Ron-Z/PCB_SD04-PCM-DW01/705_PCB_SD04-PCM-DW01/191212_shark04_dw01/readme.md

### Change log

v0.1 Draft release

v0.2 - 20200316

- 根据需求增加了 均衡指示灯
- 修改了部分不合理的布线。
