Ron-Z/PCB_SD04-PCM-DW01/705_PCB_SD04-PCM-DW01/191212_shark04_dw01/00_documentation/6A637312932F483C8EEC1C25A4D09317_419.jpg

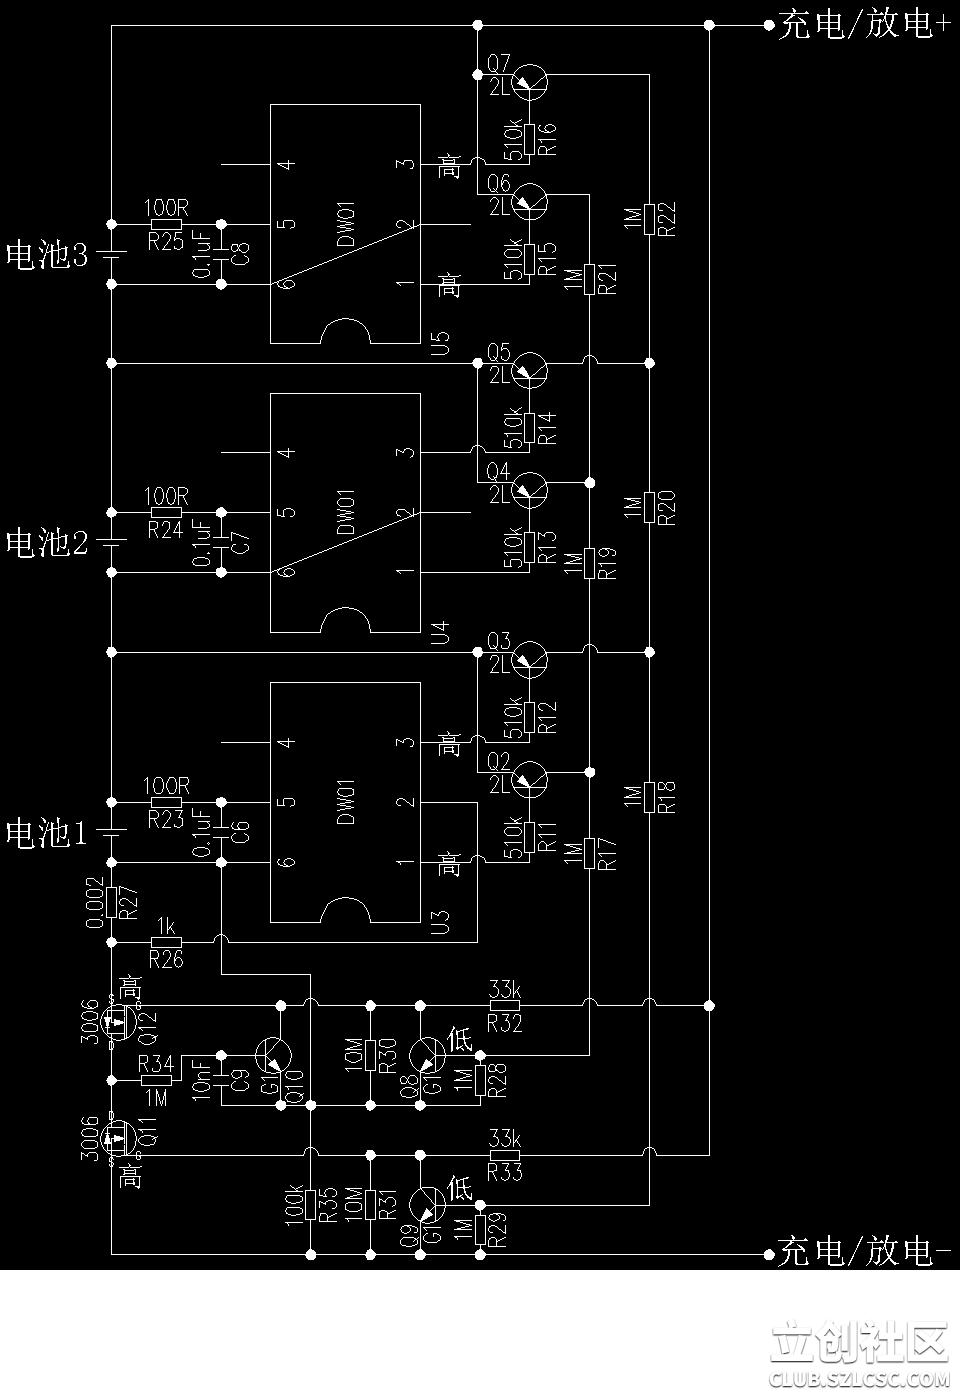
705_PCB_SD04-PCM-DW01/191212_shark04_dw01/00_documentation/6A637312932F483C8EEC1C25A4D09317_419.jpg
