Ron-Z/PCB_SD04-PCM-DW01/705_PCB_SD04-PCM-DW01/191212_shark04_dw01/00_documentation/20190611191539315.png

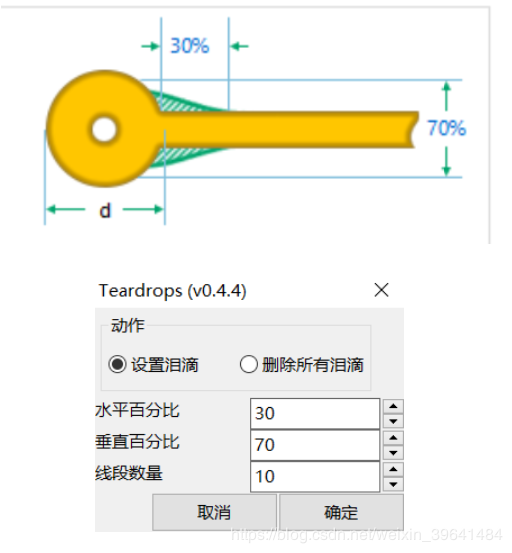
705_PCB_SD04-PCM-DW01/191212_shark04_dw01/00_documentation/20190611191539315.png
