Ron-Z/PCB_SD04-PCM-DW01/705_PCB_SD04-PCM-DW01/191212_shark04_dw01/00_documentation/DW01_ORG.png

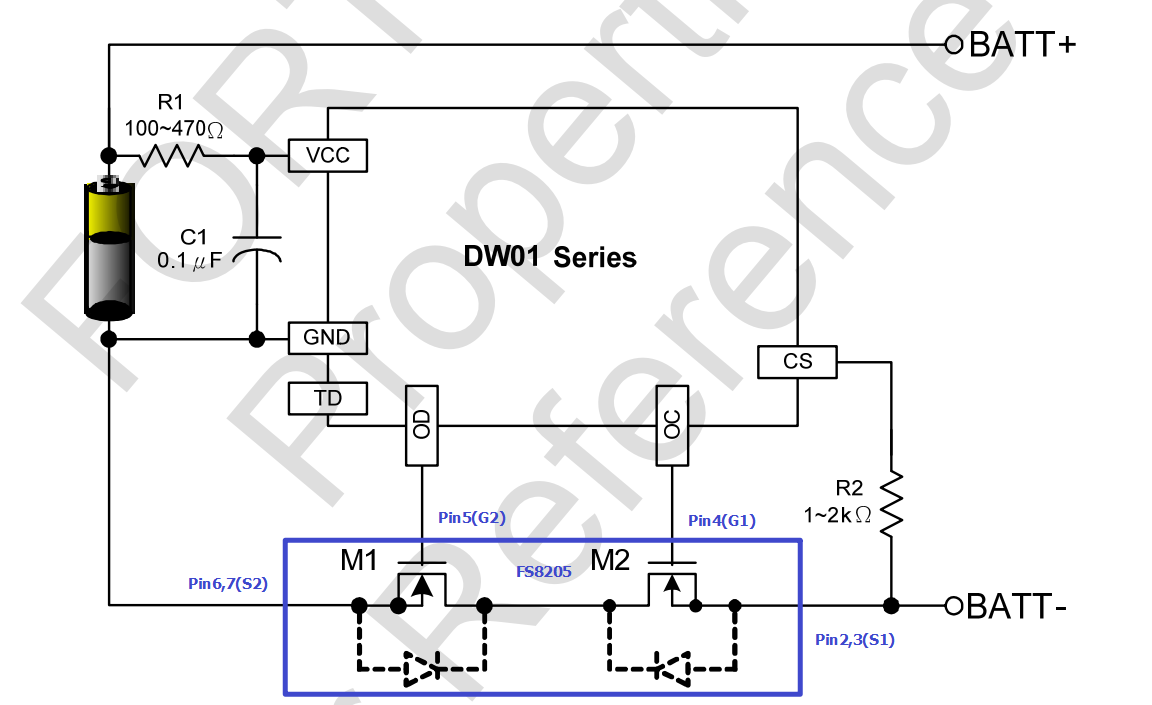
705_PCB_SD04-PCM-DW01/191212_shark04_dw01/00_documentation/DW01_ORG.png
