Ron-Z/PCB_SD04-PCM-DW01/705_PCB_SD04-PCM-DW01/191212_shark04_dw01/40_photos/SideView_SD04_v0.2.png

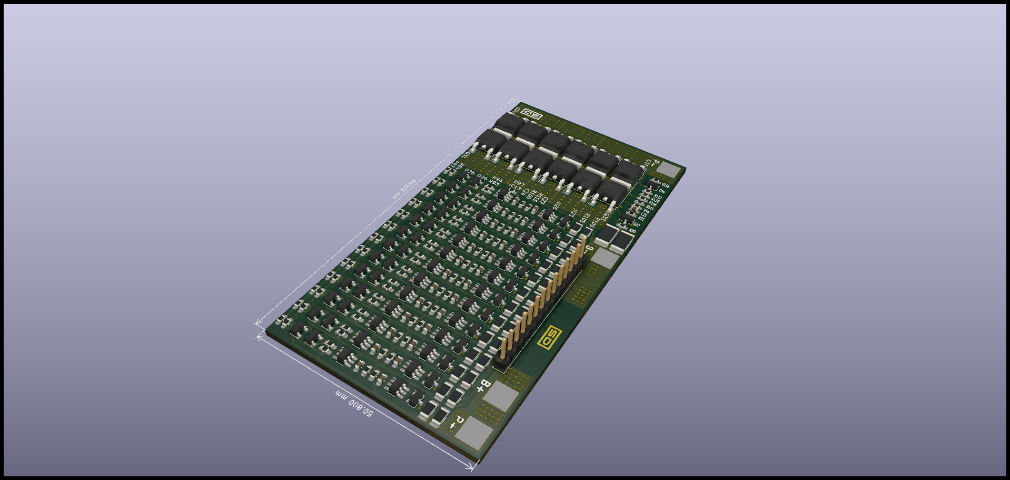
705_PCB_SD04-PCM-DW01/191212_shark04_dw01/40_photos/SideView_SD04_v0.2.png
