Ron-Z/PCB_SD04-PCM-DW01/705_PCB_SD04-PCM-DW01/191212_shark04_dw01/sd04.csv

Reference | Value | Footprint | Datasheet | Field4 | P | detail | 字段5 | 字段4
U11 | HY2213-BB3A | Package_TO_SOT_SMD:SOT-23-6_Handsoldering | https://datasheet.lcsc.com/szlcsc/HYCON-Tech-HY2213-BB3A_C113632.pdf
U1 | SLS2302 | Package_TO_SOT_SMD:SOT-23 | ~
R52 | 150R | Resistor_SMD:R_1206_3216Metric_Pad1.42x1.75mm_HandSolder
C11 | 0.1uF | Capacitor_SMD:C_0603_1608Metric_Pad1.05x0.95mm_HandSolder | ~
R72 | 100R | Resistor_SMD:R_0603_1608Metric_Pad1.05x0.95mm_HandSolder
R42 | 100R | Resistor_SMD:R_0603_1608Metric_Pad1.05x0.95mm_HandSolder
C1 | 0.1uF | Capacitor_SMD:C_0603_1608Metric_Pad1.05x0.95mm_HandSolder | ~
IC1 | DW01A-G | Package_TO_SOT_SMD:SOT-23-6_Handsoldering
Q2 | MMBT3906 | Package_TO_SOT_SMD:SOT-23 | https://www.fairchildsemi.com/datasheets/2N/2N3906.pdf
Q1 | MMBT3906 | Package_TO_SOT_SMD:SOT-23 | https://www.fairchildsemi.com/datasheets/2N/2N3906.pdf
R22 | 510K | Resistor_SMD:R_0603_1608Metric_Pad1.05x0.95mm_HandSolder
R23 | 510K | Resistor_SMD:R_0603_1608Metric_Pad1.05x0.95mm_HandSolder
R1 | 1M | Resistor_SMD:R_0603_1608Metric_Pad1.05x0.95mm_HandSolder
R12 | 1M | Resistor_SMD:R_0603_1608Metric_Pad1.05x0.95mm_HandSolder
U12 | HY2213-BB3A | Package_TO_SOT_SMD:SOT-23-6_Handsoldering | https://datasheet.lcsc.com/szlcsc/HYCON-Tech-HY2213-BB3A_C113632.pdf
U2 | SLS2302 | Package_TO_SOT_SMD:SOT-23 | ~
C12 | 0.1uF | Capacitor_SMD:C_0603_1608Metric_Pad1.05x0.95mm_HandSolder | ~
R73 | 100R | Resistor_SMD:R_0603_1608Metric_Pad1.05x0.95mm_HandSolder
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
H3 | P- | SolderWirePad_1x01_SMD_5x5mm:SolderWirePad_1x01_SMD_5x5mm | ~
J1 | CONN_14 | Connector_PinHeader_2.54mm:PinHeader_1x14_P2.54mm_Vertical |  |  |  |  |  | XXX-00000
H4 | P+ | SolderWirePad_1x01_SMD_5x5mm:SolderWirePad_1x01_SMD_5x5mm | ~
