Ron-Z/PCB_SD04-PCM-DW01/705_PCB_SD04-PCM-DW01/191212_shark04_dw01/99_others/FS8205A/FS8205A--3DModel-STEP-56544.STEP

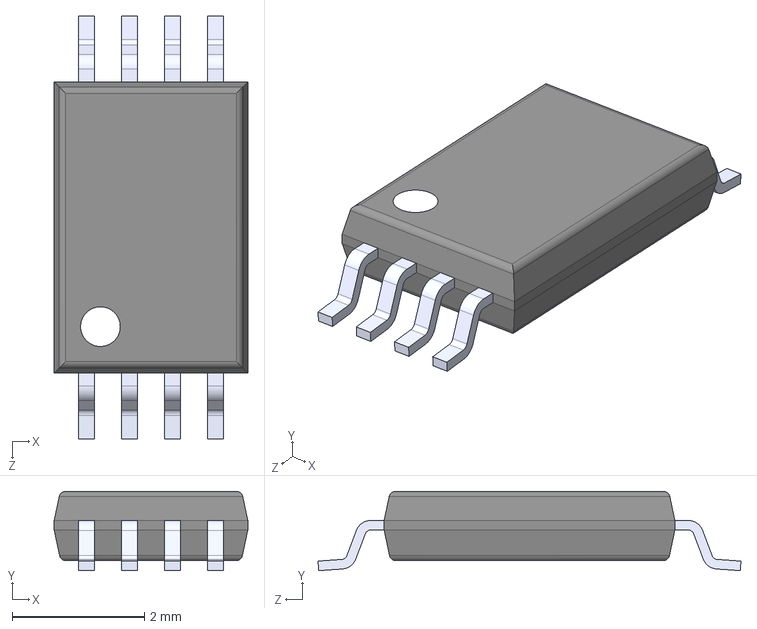
[picture p17: CAD file, 2020-03-17]
705_PCB_SD04-PCM-DW01/191212_shark04_dw01/99_others/FS8205A/FS8205A--3DModel-STEP-56544.STEP
2.93 x 1.20 x 6.40 mm
