Ron-Z/PCB_SD04-PCM-DW01/705_PCB_SD04-PCM-DW01/191212_shark04_dw01/preview_pcb.pdf

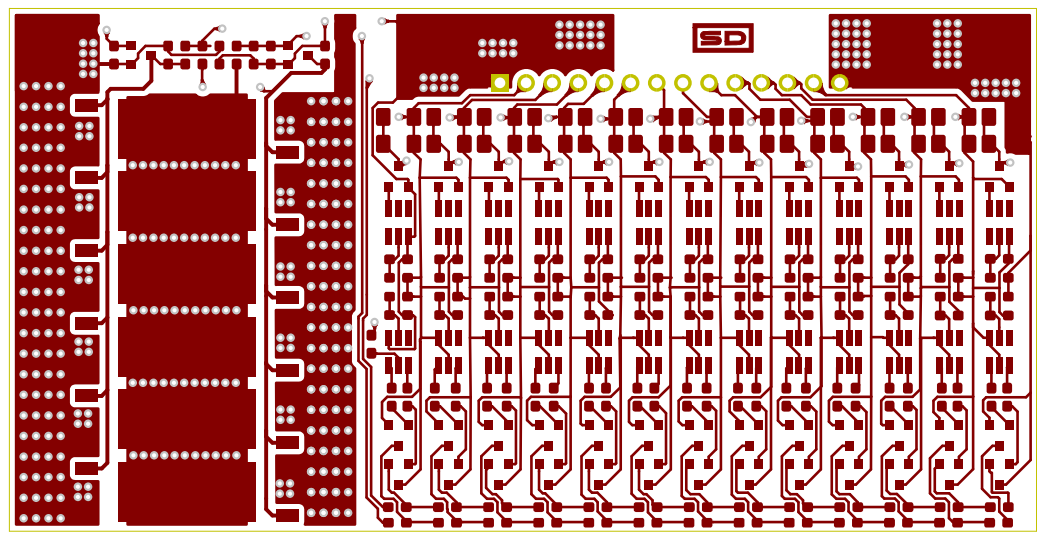
[picture p18: page 1]

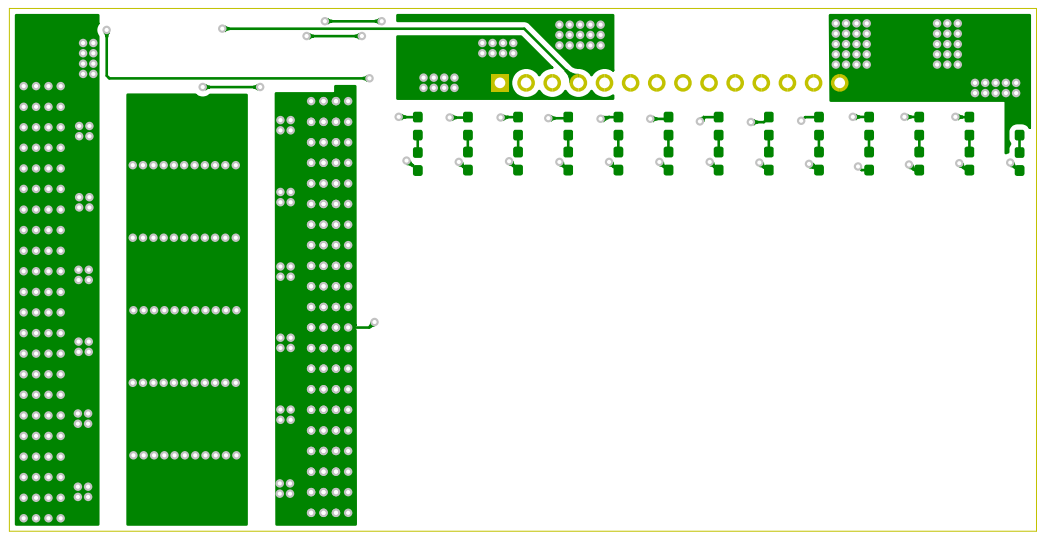
[picture p19: page 2]

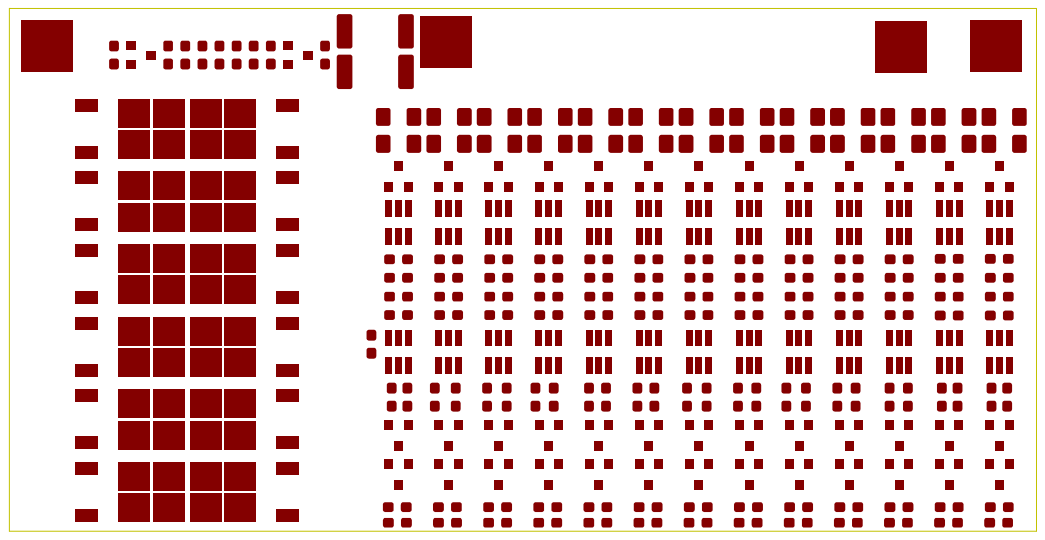
[picture p20: page 5]

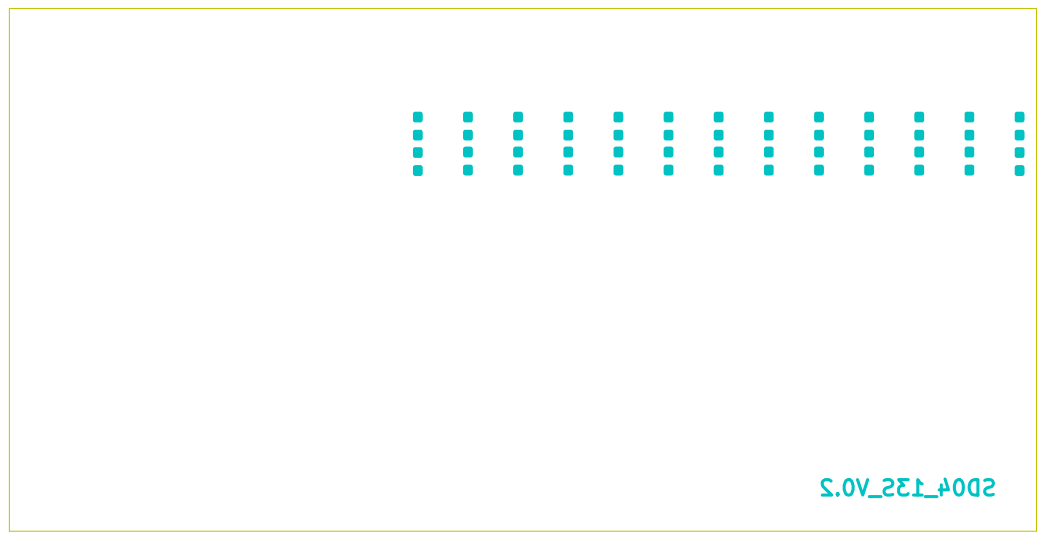
[picture p21: page 6]

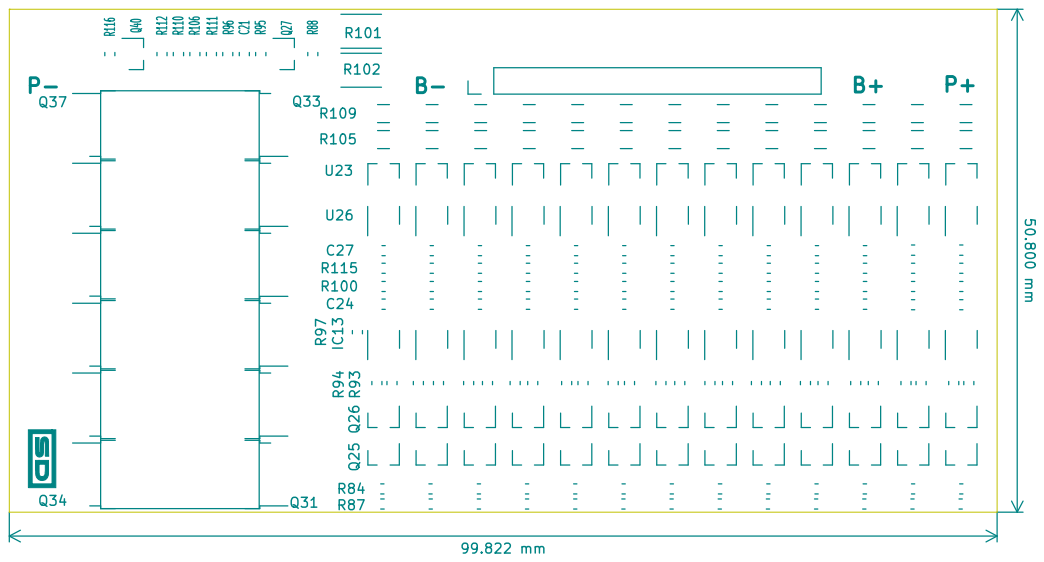
[picture p22: page 7]

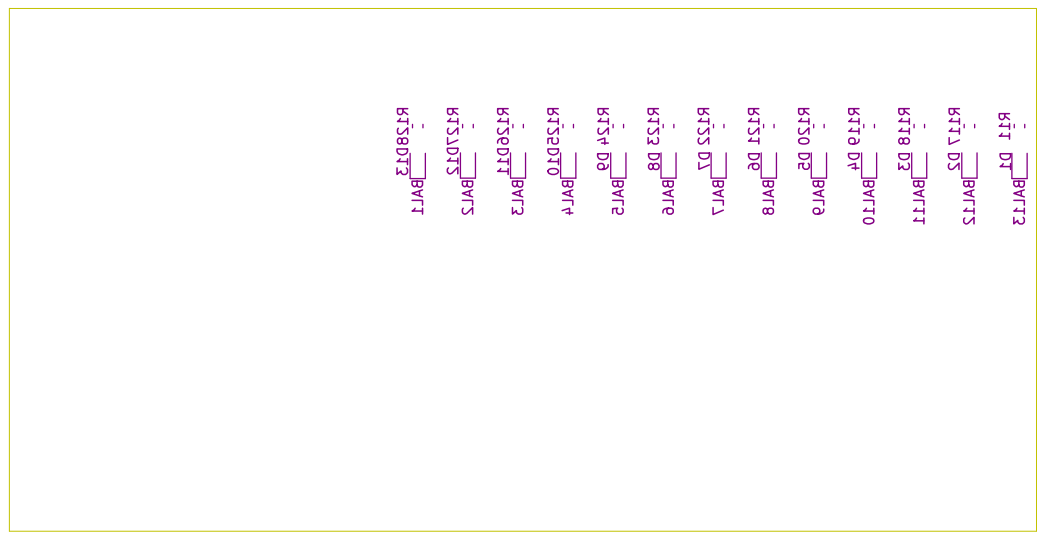
[picture p23: page 8]

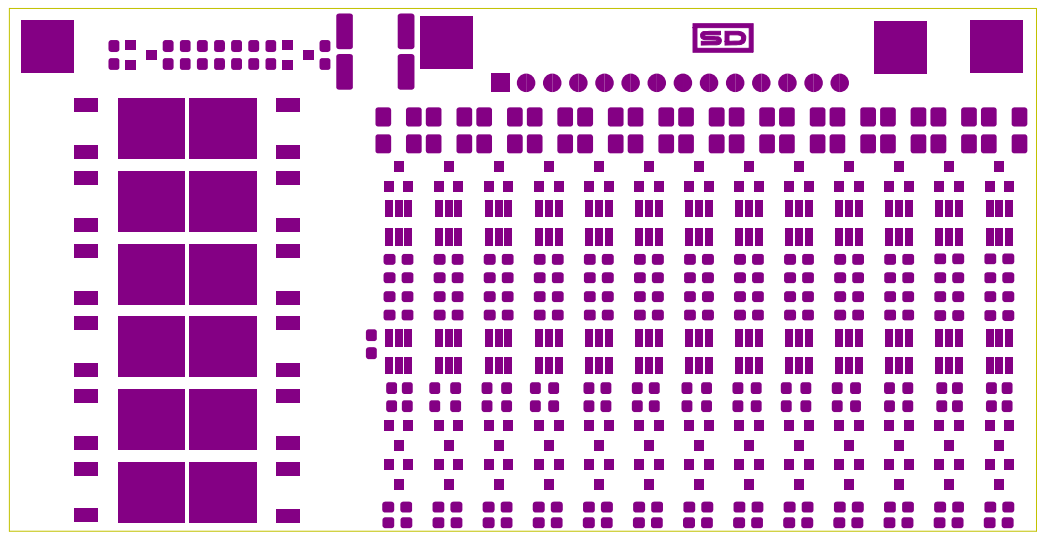
[picture p24: page 9]

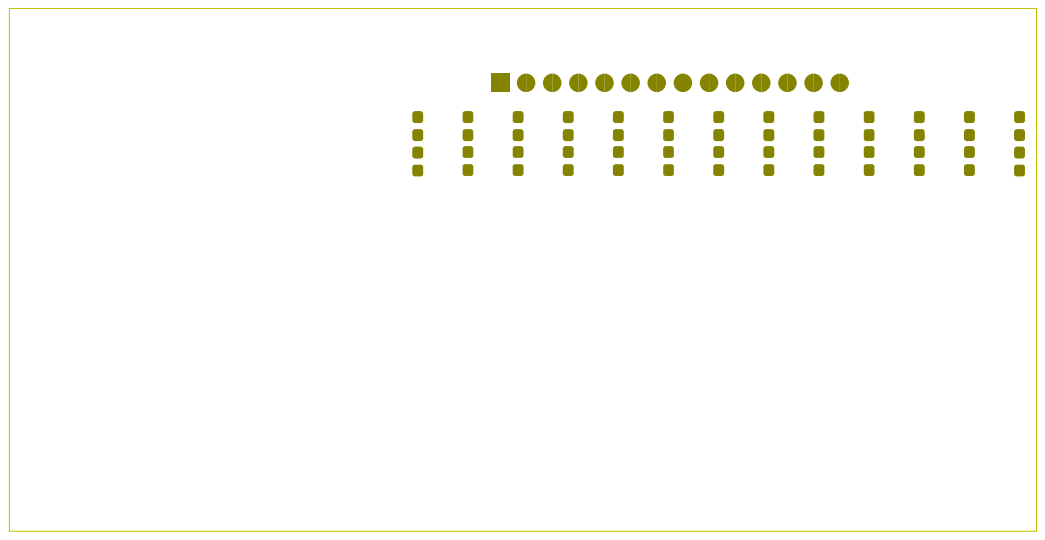
[picture p25: page 10]

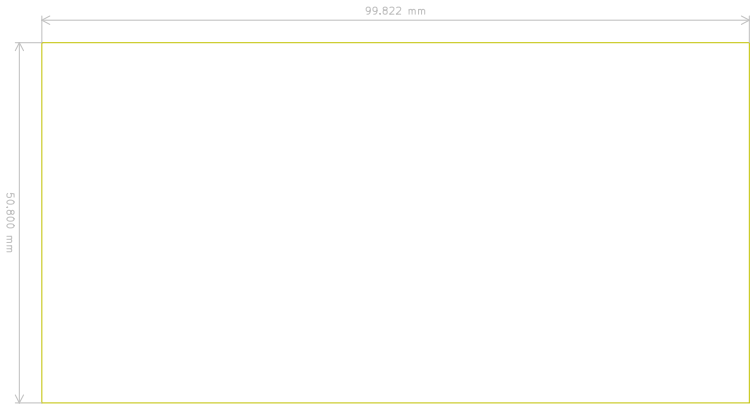
[picture p26: figure]

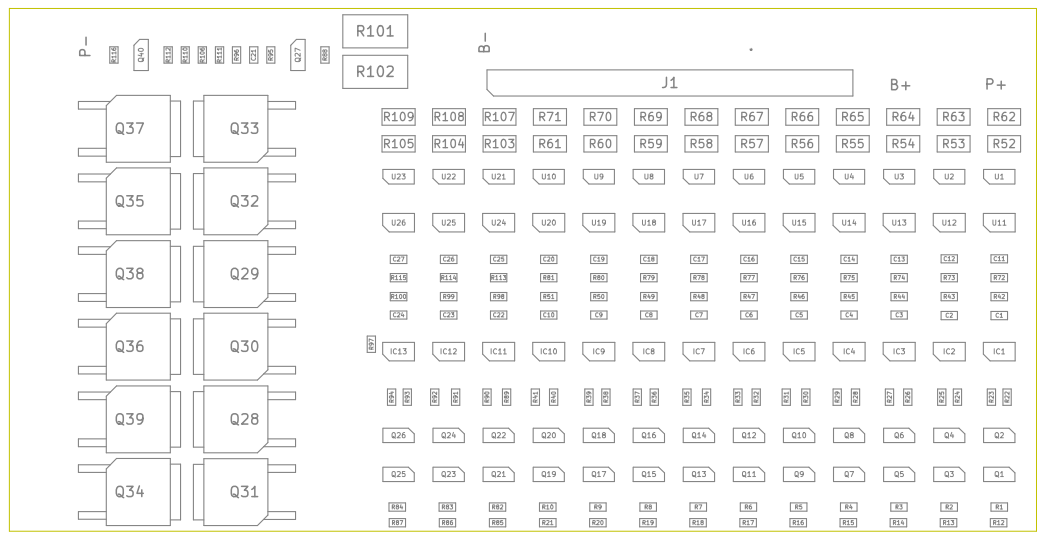
[picture p27: page 19]

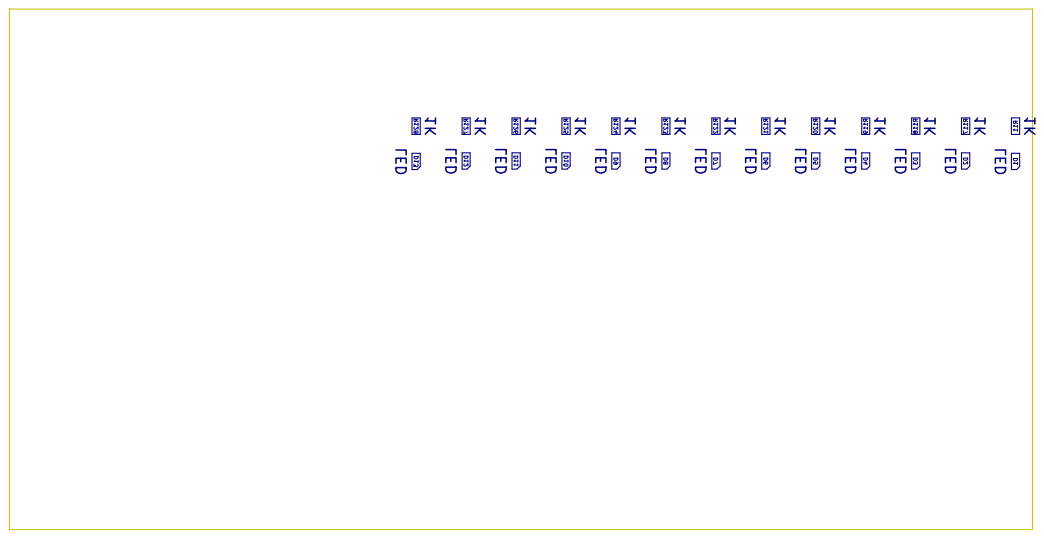
[picture p28: page 20]
