Ron-Z/PCB_SD04-PCM-DW01/705_PCB_SD04-PCM-DW01/191212_shark04_dw01/50_simulation/Gate.asc

M1: nmos
M2: nmos
M3: pmos
Q1: npn
Q2: npn
R1: res; 1Meg
R2: res; 1Meg
R3: res; 10Meg
R4: res; 1Meg
R5: res; 1
R6: res; 1Meg
R7: res; 10Meg
R8: res; 1Meg
V1: cell
V2: cell
V3: cell
V4: cell
V5: cell
V6: cell
V7: cell
V8: cell
V9: cell
V10: voltage
Named nets: 0, VCC
.tran 1
