Ron-Z/PCB_SD04-PCM-DW01/705_PCB_SD04-PCM-DW01/191212_shark04_dw01/sd04.kicad_pcb

## KiCad design 705_PCB_SD04-PCM-DW01/191212_shark04_dw01/sd04.kicad_pcb (2020-03-17)

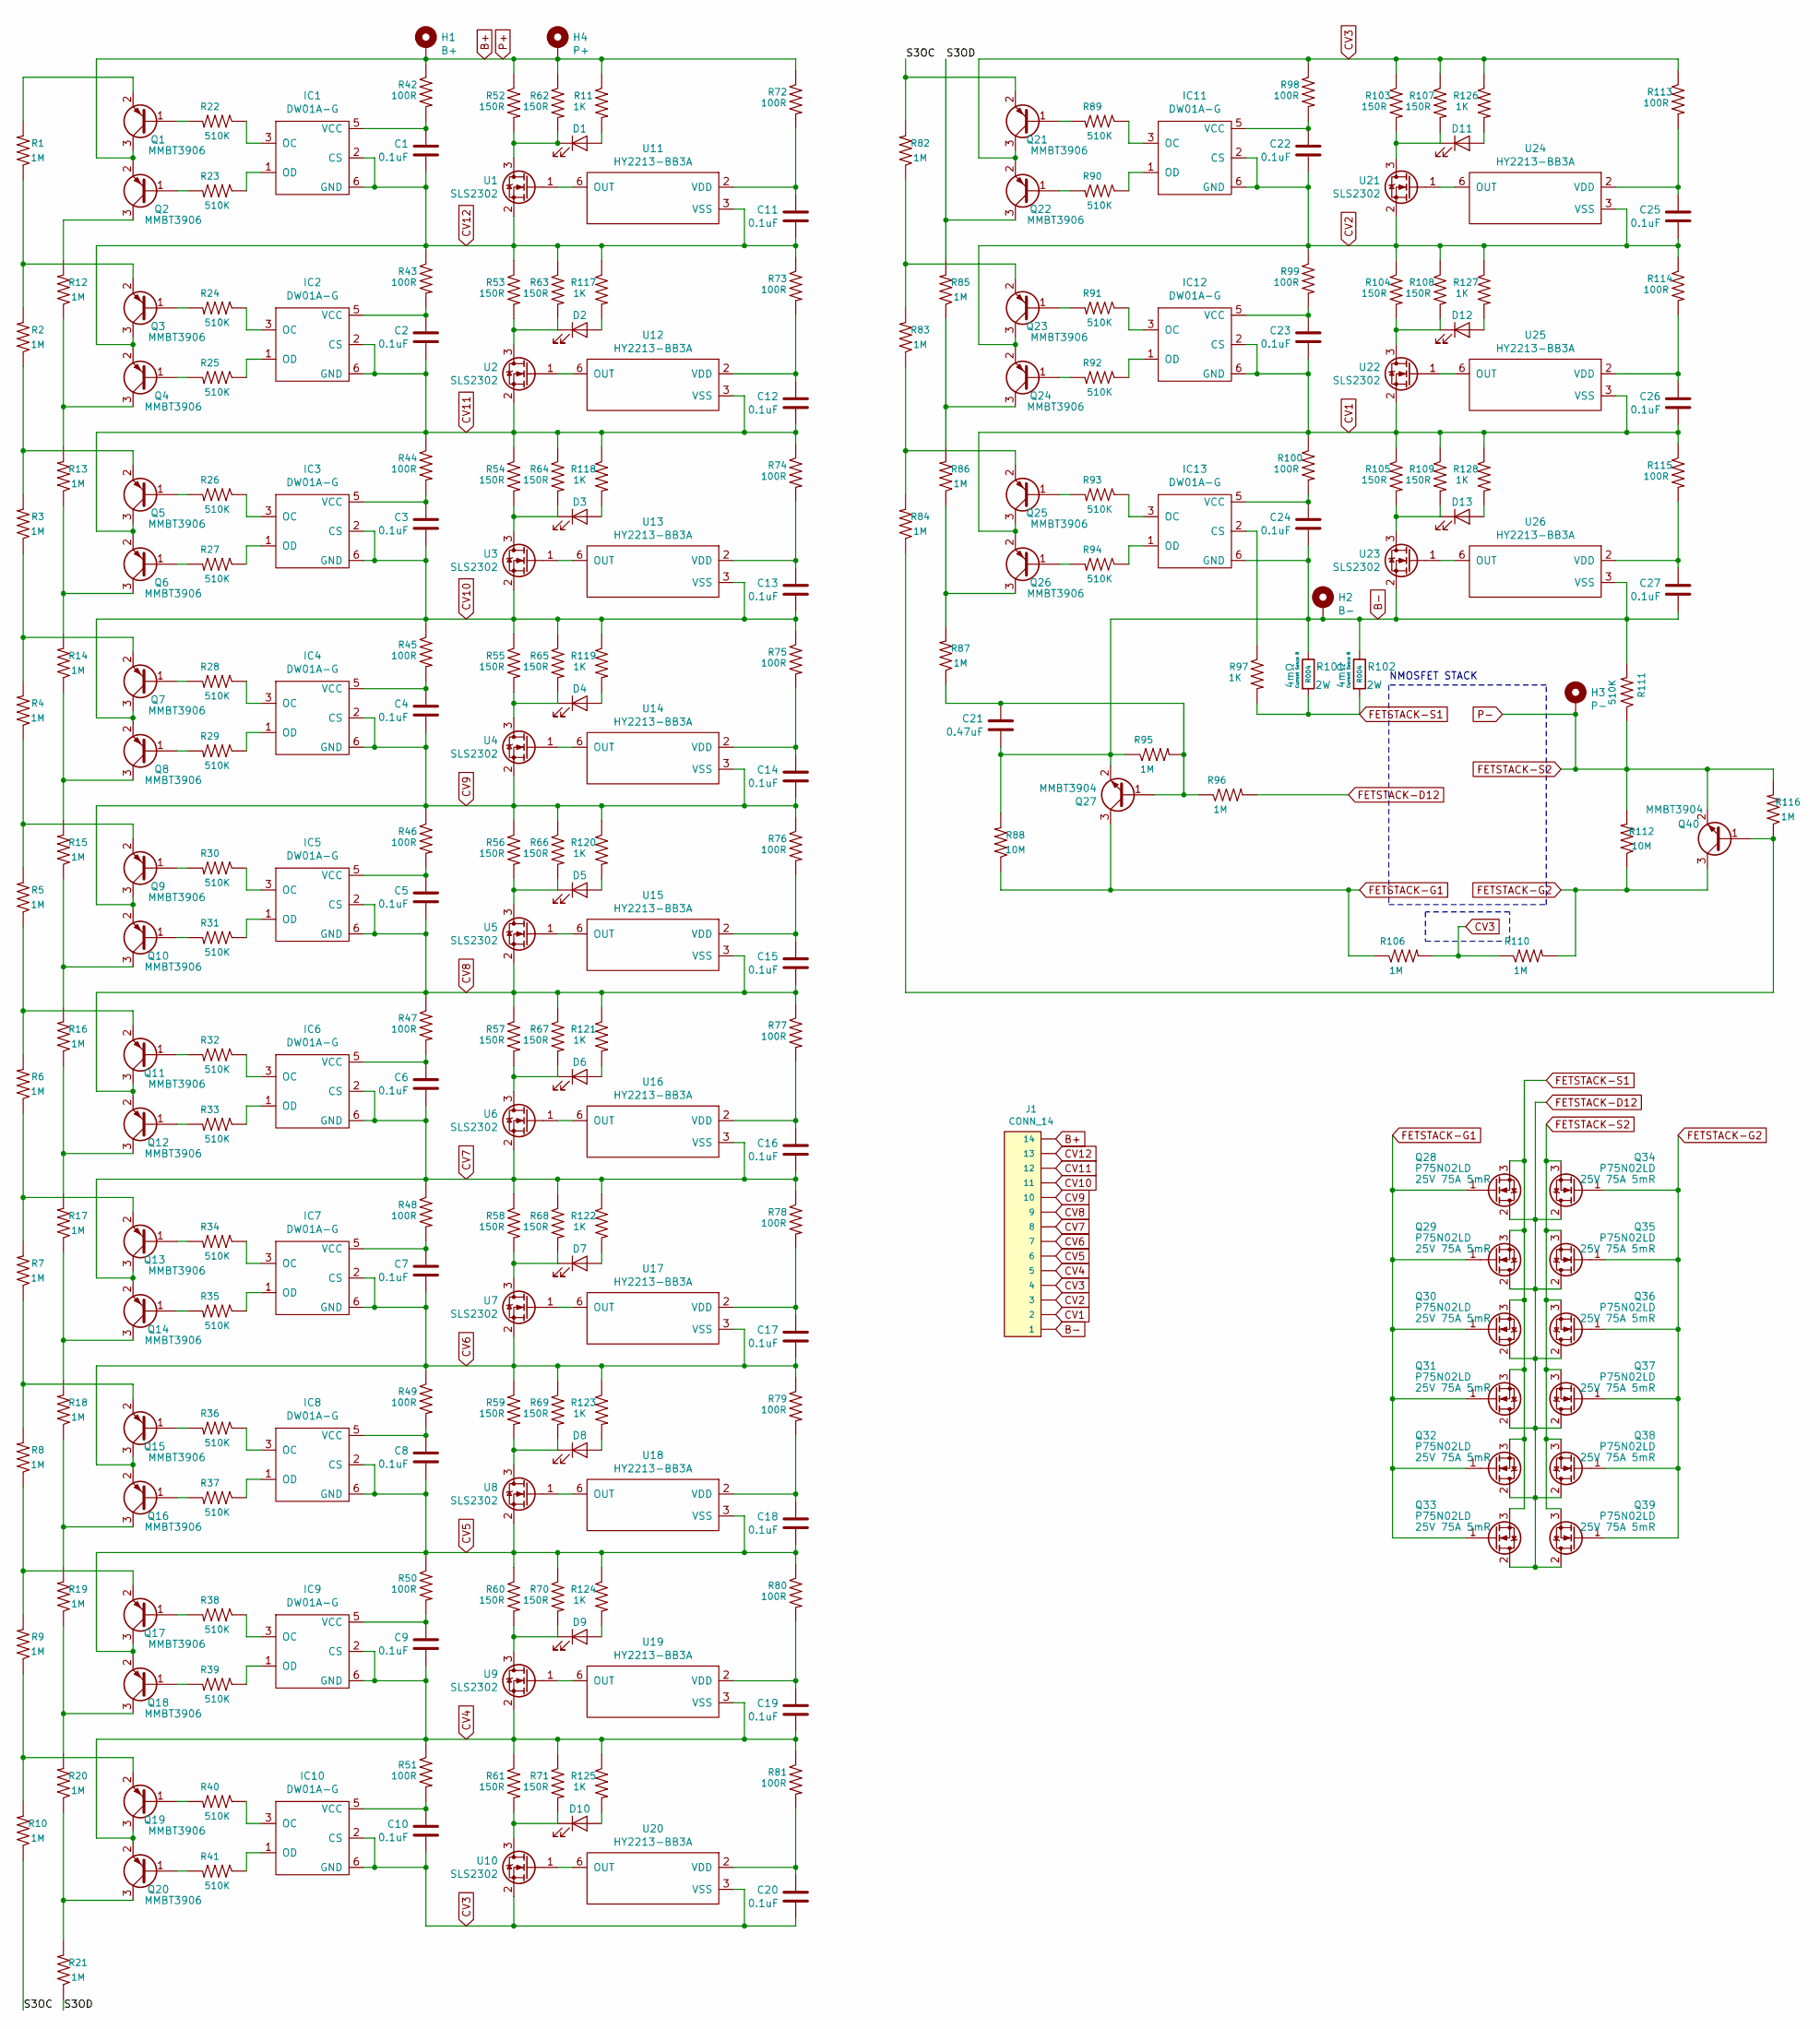
[picture p30: schematic sd04.sch, SD04_13S]

Parts:
C1, C2, C3, C4, C5, C6, C7, C8, C9, C10, C11, C12, C13, C14, C15, C16, C17, C18, C19, C20, C22, C23, C24, C25, C26, C27: 0.1uF; C_0603_1608Metric_Pad1.05x0.95mm_HandSolder
C21: 0.47uF; C_0603_1608Metric_Pad1.05x0.95mm_HandSolder
D1, D2, D3, D4, D5, D6, D7, D8, D9, D10, D11, D12, D13: LED; LED_0603_1608Metric_Pad1.05x0.95mm_HandSolder
H1: B+; SolderWirePad_1x01_SMD_5x5mm
H2: B-; SolderWirePad_1x01_SMD_5x5mm
H3: P-; SolderWirePad_1x01_SMD_5x5mm
H4: P+; SolderWirePad_1x01_SMD_5x5mm
IC1, IC2, IC3, IC4, IC5, IC6, IC7, IC8, IC9, IC10, IC11, IC12, IC13: DW01A-G; SOT-23-6_Handsoldering
J1: CONN_14; PinHeader_1x14_P2.54mm_Vertical
Q1, Q2, Q3, Q4, Q5, Q6, Q7, Q8, Q9, Q10, Q11, Q12, Q13, Q14, Q15, Q16, Q17, Q18, Q19, Q20, Q21, Q22, Q23, Q24, Q25, Q26: MMBT3906; SOT-23
Q27, Q40: MMBT3904; SOT-23
Q28, Q29, Q30, Q31, Q32, Q33, Q34, Q35, Q36, Q37, Q38, Q39: P75N02LD; TO-252-2
R1, R2, R3, R4, R5, R6, R7, R8, R9, R10, R12, R13, R14, R15, R16, R17, R18, R19, R20, R21, R82, R83, R84, R85, R86, R87, R95, R96, R106, R110, R116: 1M; R_0603_1608Metric_Pad1.05x0.95mm_HandSolder
R11, R97, R117, R118, R119, R120, R121, R122, R123, R124, R125, R126, R127, R128: 1K; R_0603_1608Metric_Pad1.05x0.95mm_HandSolder
R22, R23, R24, R25, R26, R27, R28, R29, R30, R31, R32, R33, R34, R35, R36, R37, R38, R39, R40, R41, R89, R90, R91, R92, R93, R94, R111: 510K; R_0603_1608Metric_Pad1.05x0.95mm_HandSolder
R42, R43, R44, R45, R46, R47, R48, R49, R50, R51, R72, R73, R74, R75, R76, R77, R78, R79, R80, R81, R98, R99, R100, R113, R114, R115: 100R; R_0603_1608Metric_Pad1.05x0.95mm_HandSolder
R52, R53, R54, R55, R56, R57, R58, R59, R60, R61, R62, R63, R64, R65, R66, R67, R68, R69, R70, R71, R103, R104, R105, R107, R108, R109: 150R; R_1206_3216Metric_Pad1.42x1.75mm_HandSolder
R88, R112: 10M; R_0603_1608Metric_Pad1.05x0.95mm_HandSolder
R101, R102: 4mΩ; R_2512_6332Metric_Pad1.52x3.35mm_HandSolder
U1, U2, U3, U4, U5, U6, U7, U8, U9, U10, U21, U22, U23: SLS2302; SOT-23
U11, U12, U13, U14, U15, U16, U17, U18, U19, U20, U24, U25, U26: HY2213-BB3A; SOT-23-6_Handsoldering

Connections:
/S3OC: Q21.2 (E), R10.1, R82.2
/S3OD: Q22.3 (C), R21.1, R85.2
B+: H1.1, H4.1, J1.14, Q1.3 (C), Q2.2 (E), R11.1, R42.1, R52.1, R62.1, R72.1
B-: C21.2, C24.2, C27.2, H2.1, IC13.6 (GND), J1.1, Q27.2 (E), R88.2, R95.1, R101.1, R102.1, R111.2, U23.2 (S), U26.3 (VSS)
CV1: C23.2, C26.2, IC12.2 (CS), IC12.6 (GND), J1.2, Q25.3 (C), Q26.2 (E), R100.1, R105.1, R109.1, R115.1, R128.1, U22.2 (S), U25.3 (VSS)
CV2: C22.2, C25.2, IC11.2 (CS), IC11.6 (GND), J1.3, Q23.3 (C), Q24.2 (E), R99.1, R104.1, R108.1, R114.1, R127.1, U21.2 (S), U24.3 (VSS)
CV3: C10.2, C20.2, IC10.2 (CS), IC10.6 (GND), J1.4, Q21.3 (C), Q22.2 (E), R98.1, R103.1, R106.2, R107.1, R110.1, R113.1, R126.1, U10.2 (S), U20.3 (VSS)
CV4: C9.2, C19.2, IC9.2 (CS), IC9.6 (GND), J1.5, Q19.3 (C), Q20.2 (E), R51.1, R61.1, R71.1, R81.1, R125.1, U9.2 (S), U19.3 (VSS)
CV5: C8.2, C18.2, IC8.2 (CS), IC8.6 (GND), J1.6, Q17.3 (C), Q18.2 (E), R50.1, R60.1, R70.1, R80.1, R124.1, U8.2 (S), U18.3 (VSS)
CV6: C7.2, C17.2, IC7.2 (CS), IC7.6 (GND), J1.7, Q15.3 (C), Q16.2 (E), R49.1, R59.1, R69.1, R79.1, R123.1, U7.2 (S), U17.3 (VSS)
CV7: C6.2, C16.2, IC6.2 (CS), IC6.6 (GND), J1.8, Q13.3 (C), Q14.2 (E), R48.1, R58.1, R68.1, R78.1, R122.1, U6.2 (S), U16.3 (VSS)
CV8: C5.2, C15.2, IC5.2 (CS), IC5.6 (GND), J1.9, Q11.3 (C), Q12.2 (E), R47.1, R57.1, R67.1, R77.1, R121.1, U5.2 (S), U15.3 (VSS)
CV9: C4.2, C14.2, IC4.2 (CS), IC4.6 (GND), J1.10, Q9.3 (C), Q10.2 (E), R46.1, R56.1, R66.1, R76.1, R120.1, U4.2 (S), U14.3 (VSS)
CV10: C3.2, C13.2, IC3.2 (CS), IC3.6 (GND), J1.11, Q7.3 (C), Q8.2 (E), R45.1, R55.1, R65.1, R75.1, R119.1, U3.2 (S), U13.3 (VSS)
CV11: C2.2, C12.2, IC2.2 (CS), IC2.6 (GND), J1.12, Q5.3 (C), Q6.2 (E), R44.1, R54.1, R64.1, R74.1, R118.1, U2.2 (S), U12.3 (VSS)
CV12: C1.2, C11.2, IC1.2 (CS), IC1.6 (GND), J1.13, Q3.3 (C), Q4.2 (E), R43.1, R53.1, R63.1, R73.1, R117.1, U1.2 (S), U11.3 (VSS)
FETSTACK-D12: Q28.2 (D), Q29.2 (D), Q30.2 (D), Q31.2 (D), Q32.2 (D), Q33.2 (D), Q34.2 (D), Q35.2 (D), Q36.2 (D), Q37.2 (D), Q38.2 (D), Q39.2 (D), R96.2
FETSTACK-G1: Q27.3 (C), Q28.1 (G), Q29.1 (G), Q30.1 (G), Q31.1 (G), Q32.1 (G), Q33.1 (G), R88.1, R106.1
FETSTACK-G2: Q34.1 (G), Q35.1 (G), Q36.1 (G), Q37.1 (G), Q38.1 (G), Q39.1 (G), Q40.3 (C), R110.2, R112.1
FETSTACK-S1: Q28.3 (S), Q29.3 (S), Q30.3 (S), Q31.3 (S), Q32.3 (S), Q33.3 (S), R97.2, R101.2, R102.2
FETSTACK-S2: H3.1, Q34.3 (S), Q35.3 (S), Q36.3 (S), Q37.3 (S), Q38.3 (S), Q39.3 (S), Q40.2 (E), R111.1, R112.2, R116.2
unnamed: C1.1, IC1.5 (VCC), R42.2
unnamed: C2.1, IC2.5 (VCC), R43.2
unnamed: C3.1, IC3.5 (VCC), R44.2
unnamed: C4.1, IC4.5 (VCC), R45.2
unnamed: C5.1, IC5.5 (VCC), R46.2
unnamed: C6.1, IC6.5 (VCC), R47.2
unnamed: C7.1, IC7.5 (VCC), R48.2
unnamed: C8.1, IC8.5 (VCC), R49.2
unnamed: C9.1, IC9.5 (VCC), R50.2
unnamed: C10.1, IC10.5 (VCC), R51.2
unnamed: C11.1, R72.2, U11.2 (VDD)
unnamed: C12.1, R73.2, U12.2 (VDD)
unnamed: C13.1, R74.2, U13.2 (VDD)
unnamed: C14.1, R75.2, U14.2 (VDD)
unnamed: C15.1, R76.2, U15.2 (VDD)
unnamed: C16.1, R77.2, U16.2 (VDD)
unnamed: C17.1, R78.2, U17.2 (VDD)
unnamed: C18.1, R79.2, U18.2 (VDD)
unnamed: C19.1, R80.2, U19.2 (VDD)
unnamed: C20.1, R81.2, U20.2 (VDD)
unnamed: C21.1, Q27.1 (B), R87.1, R95.2, R96.1
unnamed: C22.1, IC11.5 (VCC), R98.2
unnamed: C23.1, IC12.5 (VCC), R99.2
unnamed: C24.1, IC13.5 (VCC), R100.2
unnamed: C25.1, R113.2, U24.2 (VDD)
unnamed: C26.1, R114.2, U25.2 (VDD)
unnamed: C27.1, R115.2, U26.2 (VDD)
unnamed: D1.1 (K), R52.2, R62.2, U1.3 (D)
unnamed: D1.2 (A), R11.2
unnamed: D2.1 (K), R53.2, R63.2, U2.3 (D)
unnamed: D2.2 (A), R117.2
unnamed: D3.1 (K), R54.2, R64.2, U3.3 (D)
unnamed: D3.2 (A), R118.2
unnamed: D4.1 (K), R55.2, R65.2, U4.3 (D)
unnamed: D4.2 (A), R119.2
unnamed: D5.1 (K), R56.2, R66.2, U5.3 (D)
unnamed: D5.2 (A), R120.2
unnamed: D6.1 (K), R57.2, R67.2, U6.3 (D)
unnamed: D6.2 (A), R121.2
unnamed: D7.1 (K), R58.2, R68.2, U7.3 (D)
unnamed: D7.2 (A), R122.2
unnamed: D8.1 (K), R59.2, R69.2, U8.3 (D)
unnamed: D8.2 (A), R123.2
unnamed: D9.1 (K), R60.2, R70.2, U9.3 (D)
unnamed: D9.2 (A), R124.2
unnamed: D10.1 (K), R61.2, R71.2, U10.3 (D)
unnamed: D10.2 (A), R125.2
unnamed: D11.1 (K), R103.2, R107.2, U21.3 (D)
unnamed: D11.2 (A), R126.2
unnamed: D12.1 (K), R104.2, R108.2, U22.3 (D)
unnamed: D12.2 (A), R127.2
unnamed: D13.1 (K), R105.2, R109.2, U23.3 (D)
unnamed: D13.2 (A), R128.2
unnamed: IC1.1 (OD), R23.1
unnamed: IC1.3 (OC), R22.1
unnamed: IC2.1 (OD), R25.1
unnamed: IC2.3 (OC), R24.1
unnamed: IC3.1 (OD), R27.1
unnamed: IC3.3 (OC), R26.1
unnamed: IC4.1 (OD), R29.1
unnamed: IC4.3 (OC), R28.1
unnamed: IC5.1 (OD), R31.1
unnamed: IC5.3 (OC), R30.1
unnamed: IC6.1 (OD), R33.1
unnamed: IC6.3 (OC), R32.1
unnamed: IC7.1 (OD), R35.1
unnamed: IC7.3 (OC), R34.1
unnamed: IC8.1 (OD), R37.1
unnamed: IC8.3 (OC), R36.1
unnamed: IC9.1 (OD), R39.1
unnamed: IC9.3 (OC), R38.1
unnamed: IC10.1 (OD), R41.1
unnamed: IC10.3 (OC), R40.1
unnamed: IC11.1 (OD), R90.1
unnamed: IC11.3 (OC), R89.1
unnamed: IC12.1 (OD), R92.1
unnamed: IC12.3 (OC), R91.1
unnamed: IC13.1 (OD), R94.1
unnamed: IC13.2 (CS), R97.1
unnamed: IC13.3 (OC), R93.1
unnamed: Q1.1 (B), R22.2
unnamed: Q1.2 (E), R1.2
unnamed: Q2.1 (B), R23.2
unnamed: Q2.3 (C), R12.2
unnamed: Q3.1 (B), R24.2
unnamed: Q3.2 (E), R1.1, R2.2
unnamed: Q4.1 (B), R25.2
unnamed: Q4.3 (C), R12.1, R13.2
unnamed: Q5.1 (B), R26.2
unnamed: Q5.2 (E), R2.1, R3.2
unnamed: Q6.1 (B), R27.2
unnamed: Q6.3 (C), R13.1, R14.2
unnamed: Q7.1 (B), R28.2
unnamed: Q7.2 (E), R3.1, R4.2
unnamed: Q8.1 (B), R29.2
unnamed: Q8.3 (C), R14.1, R15.2
unnamed: Q9.1 (B), R30.2
unnamed: Q9.2 (E), R4.1, R5.2
unnamed: Q10.1 (B), R31.2
unnamed: Q10.3 (C), R15.1, R16.2
unnamed: Q11.1 (B), R32.2
unnamed: Q11.2 (E), R5.1, R6.2
unnamed: Q12.1 (B), R33.2
unnamed: Q12.3 (C), R16.1, R17.2
unnamed: Q13.1 (B), R34.2
unnamed: Q13.2 (E), R6.1, R7.2
unnamed: Q14.1 (B), R35.2
unnamed: Q14.3 (C), R17.1, R18.2
unnamed: Q15.1 (B), R36.2
unnamed: Q15.2 (E), R7.1, R8.2
unnamed: Q16.1 (B), R37.2
unnamed: Q16.3 (C), R18.1, R19.2
unnamed: Q17.1 (B), R38.2
unnamed: Q17.2 (E), R8.1, R9.2
unnamed: Q18.1 (B), R39.2
unnamed: Q18.3 (C), R19.1, R20.2
unnamed: Q19.1 (B), R40.2
unnamed: Q19.2 (E), R9.1, R10.2
unnamed: Q20.1 (B), R41.2
unnamed: Q20.3 (C), R20.1, R21.2
unnamed: Q21.1 (B), R89.2
unnamed: Q22.1 (B), R90.2
unnamed: Q23.1 (B), R91.2
unnamed: Q23.2 (E), R82.1, R83.2
unnamed: Q24.1 (B), R92.2
unnamed: Q24.3 (C), R85.1, R86.2
unnamed: Q25.1 (B), R93.2
unnamed: Q25.2 (E), R83.1, R84.2
unnamed: Q26.1 (B), R94.2
unnamed: Q26.3 (C), R86.1, R87.2
unnamed: Q40.1 (B), R84.1, R116.1
unnamed: U1.1 (G), U11.6 (OUT)
unnamed: U10.1 (G), U20.6 (OUT)
unnamed: U2.1 (G), U12.6 (OUT)
unnamed: U3.1 (G), U13.6 (OUT)
unnamed: U4.1 (G), U14.6 (OUT)
unnamed: U5.1 (G), U15.6 (OUT)
unnamed: U6.1 (G), U16.6 (OUT)
unnamed: U7.1 (G), U17.6 (OUT)
unnamed: U8.1 (G), U18.6 (OUT)
unnamed: U9.1 (G), U19.6 (OUT)
unnamed: U21.1 (G), U24.6 (OUT)
unnamed: U22.1 (G), U25.6 (OUT)
unnamed: U23.1 (G), U26.6 (OUT)

Notes on the sheet:
NMOSFET STACK

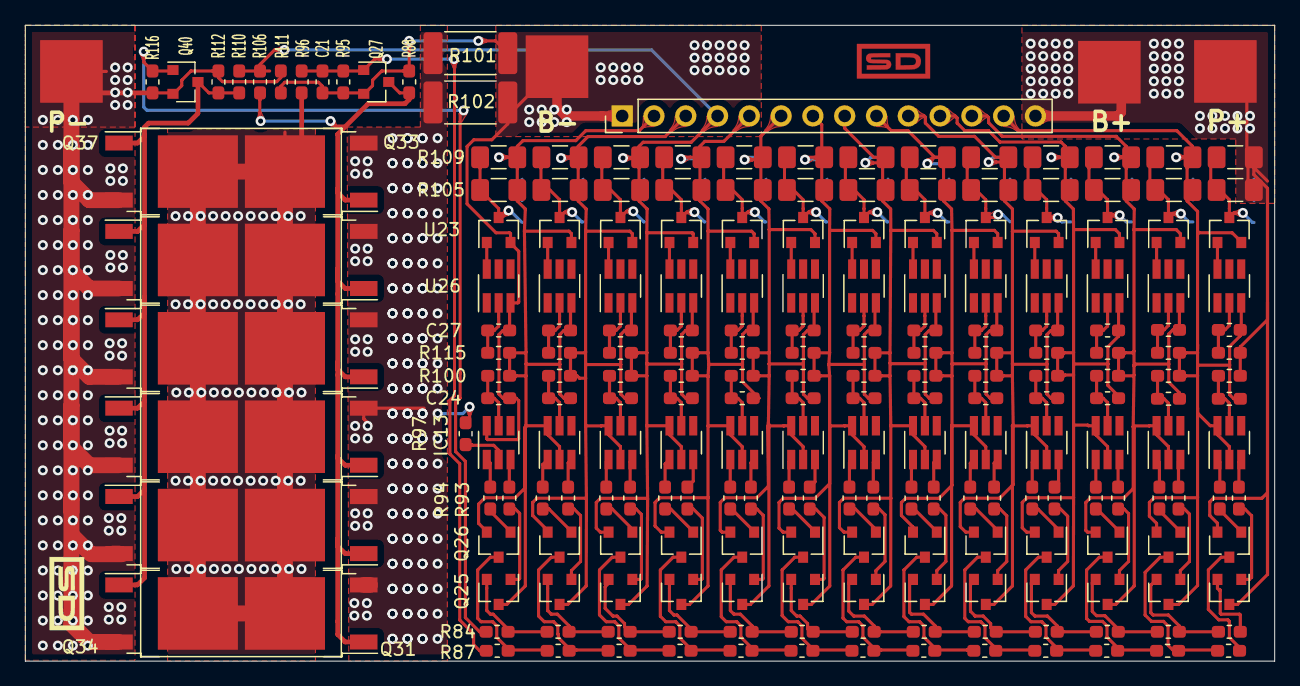
[picture p31: board sd04.kicad_pcb from above]

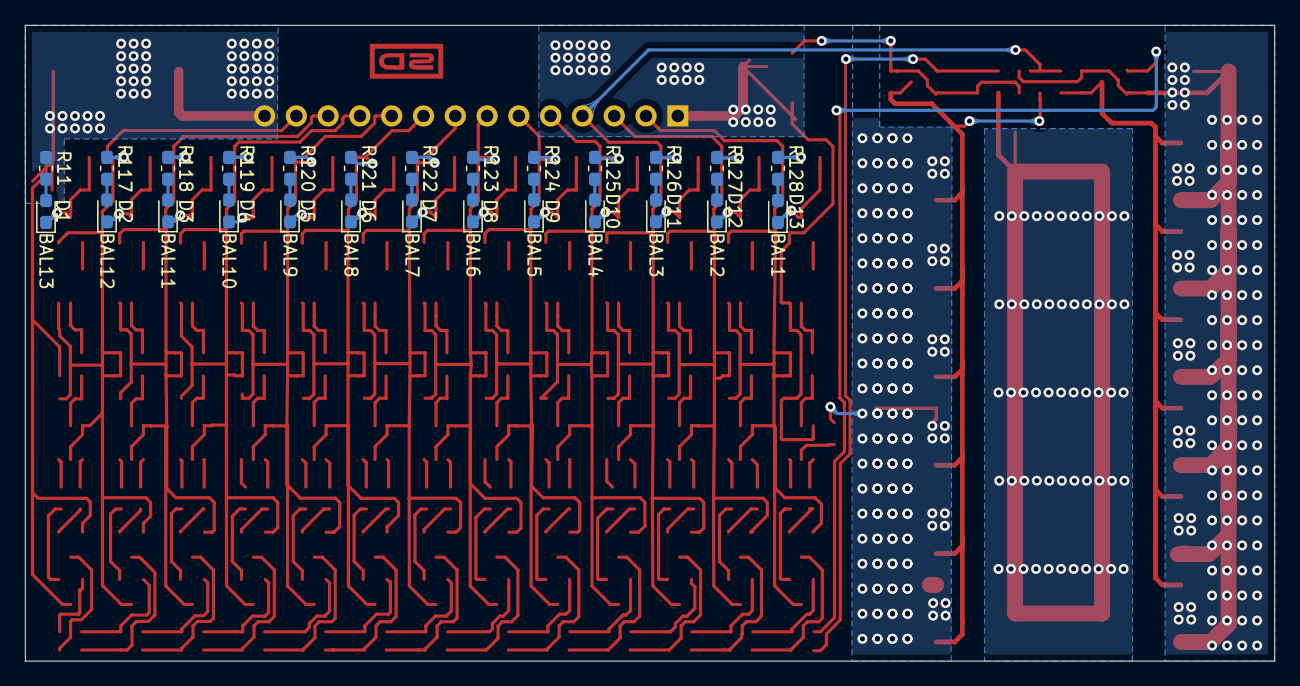
[picture p32: board sd04.kicad_pcb from below]

Board: 2 copper layers, 99.8 x 50.8 mm, 253 parts (26 on the bottom side), 165 nets.

Other parts of the board:
*: *; sd_logo_front_copper_with_mask
